shescitech/TIFR_Mask_Efficiency/design/README.md

# TIFR Mask Efficiency Measurement and Enhancement Setup

Here we present an easy to make Mask efficiency testing device using a Plantower 7003 sensor.
This sensor has been traditionally used for measuring Air Quality Index.

Different kinds of masks are available for protection against coronavirus, as shown in the image below:

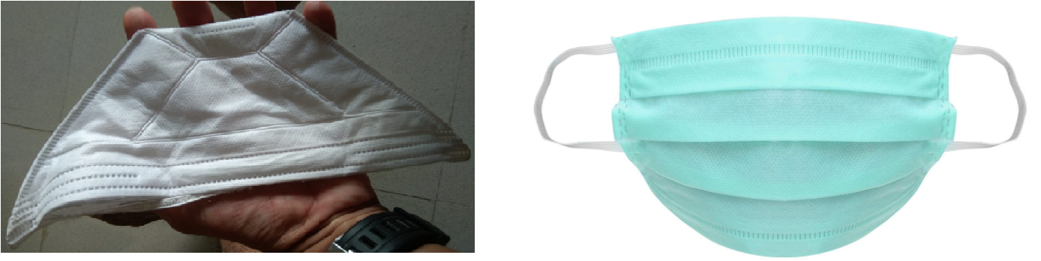
[picture p1: design/Masks.png]
alt Mask


Some people use a simple handkerchief or cloth to cover the face as well.

All of these have varying efficiencies of protection against the viruses. 

The project consists of all code design and documentation to design face mask efficiency tester

## Publication
Have a look at our pre-print to get more insight of our work
[Recharging improves efficiency of decontaminated N95 masks](https://arxiv.org/abs/2004.13641)

## Design of the Mask Tester
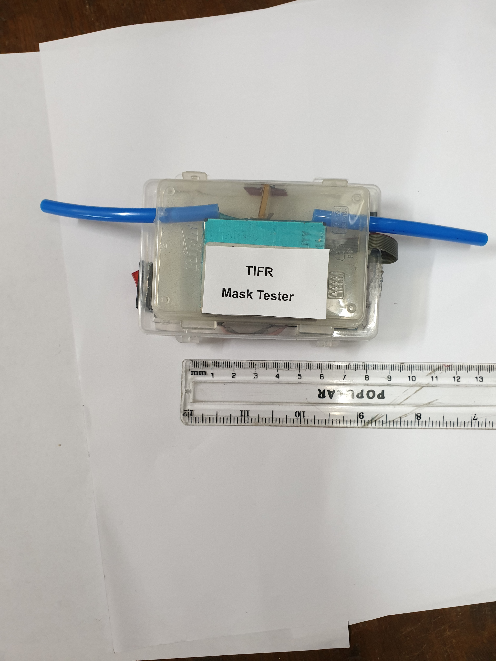
[picture p2: design/MaskTeseterClosed.jpg]
alt Mask


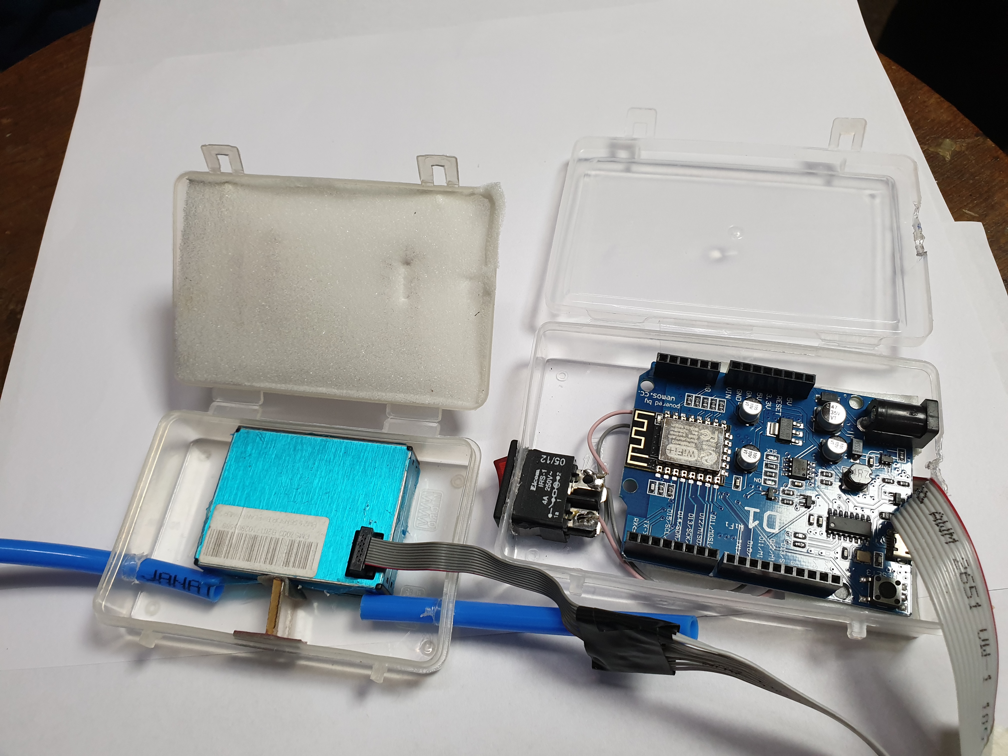
[picture p3: design/MaskTesterOpen.jpg]
alt Mask


## About us

We are a small group in TIFR working on the design of low cost mask testing equipment and efficient mask design. 

## Contact us

Want to discuss more with us:
Drop an email at shescitech@gmail.com
