shescitech/TIFR_Mask_Efficiency/python/README.md

# Data Recorder
1. You can use this file to get access to real time data from the particle counter via telnet server. For this you need to enable the telnet protocol in your computer if it is not enabled already. 
2. Add filters, analysis, and plot features as required. 
3. Data is finally exported to file "data.csv" by default.
