shescitech/TIFR_Mask_Efficiency/design/N95Mask.jpeg

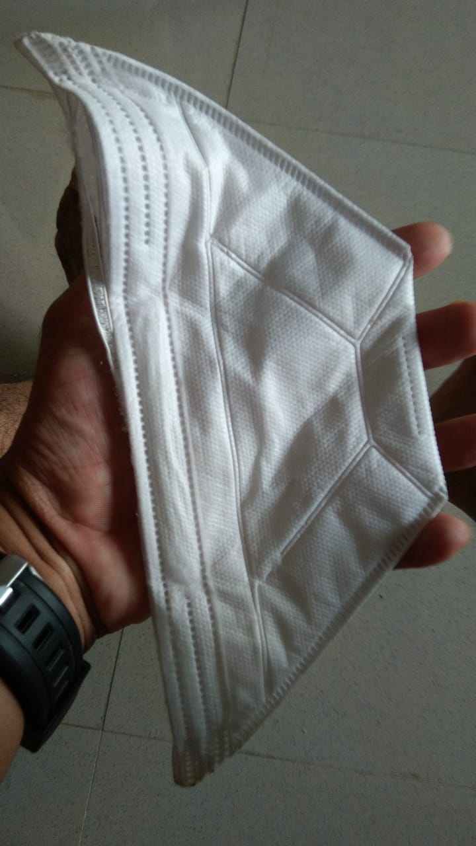
design/N95Mask.jpeg
