shescitech/TIFR_Mask_Efficiency/design/Schematic_ESP8266-PMS7003.png

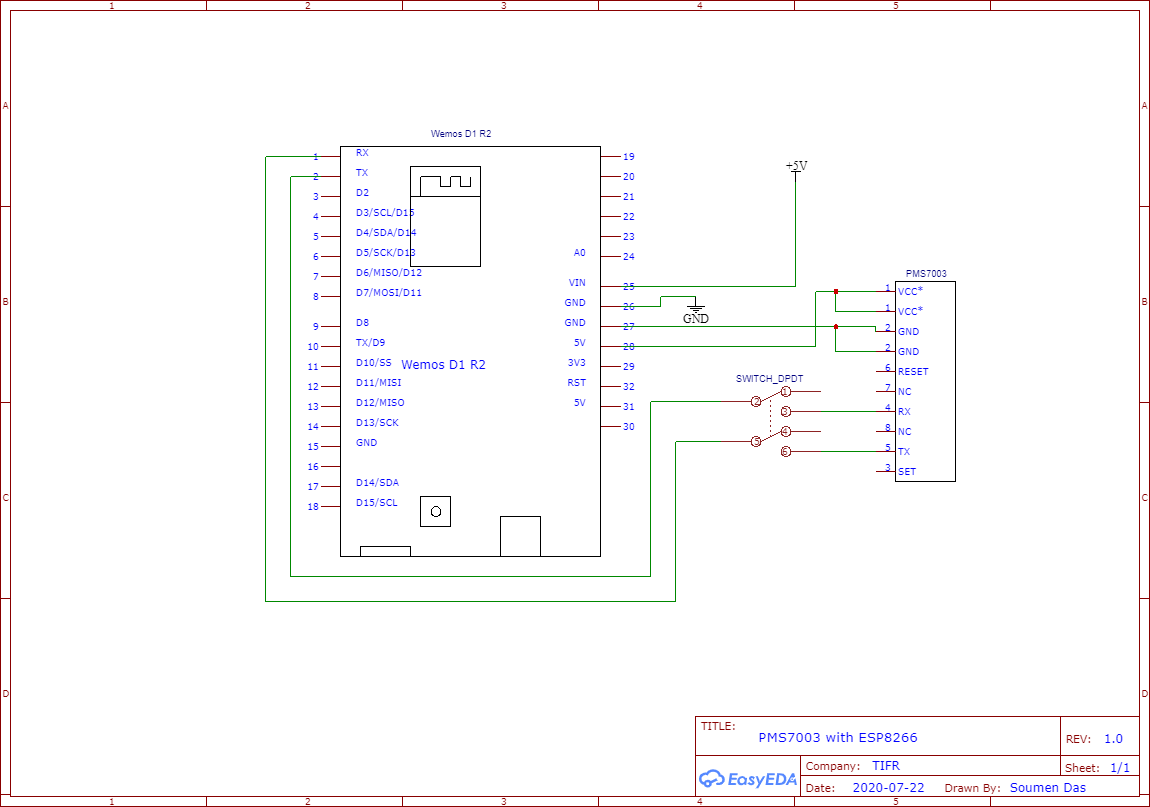
design/Schematic_ESP8266-PMS7003.png
