shescitech/TIFR_Mask_Efficiency/web/code/images/arnab.png

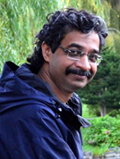
web/code/images/arnab.png
