shescitech/TIFR_Mask_Efficiency/web/code/images/emroj.png

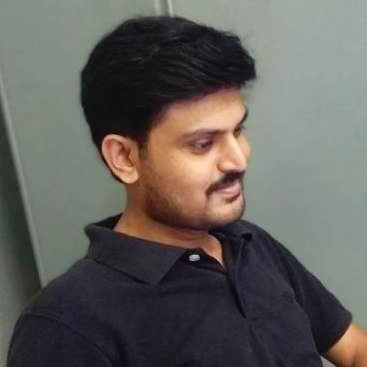
web/code/images/emroj.png
