shescitech/TIFR_Mask_Efficiency/web/code/images/harsh.jpg

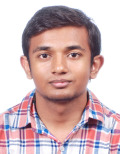
web/code/images/harsh.jpg
