shescitech/TIFR_Mask_Efficiency/web/code/images/satyanu.jpg

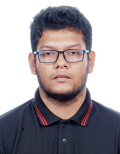
web/code/images/satyanu.jpg
