shescitech/TIFR_Mask_Efficiency/web/code/images/shankar.jpg

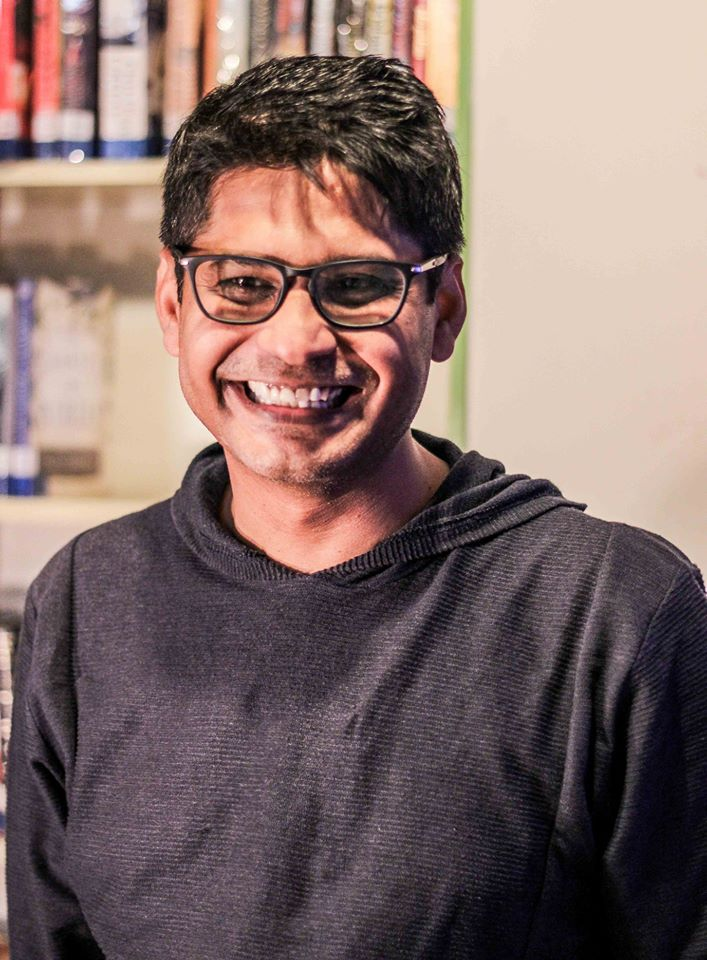
web/code/images/shankar.jpg
