shescitech/TIFR_Mask_Efficiency/web/code/images/soumen.jpg

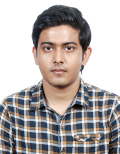
web/code/images/soumen.jpg
