shescitech/TIFR_Mask_Efficiency/design/Schematic_ESP8266-PMS7003.pdf

+5V

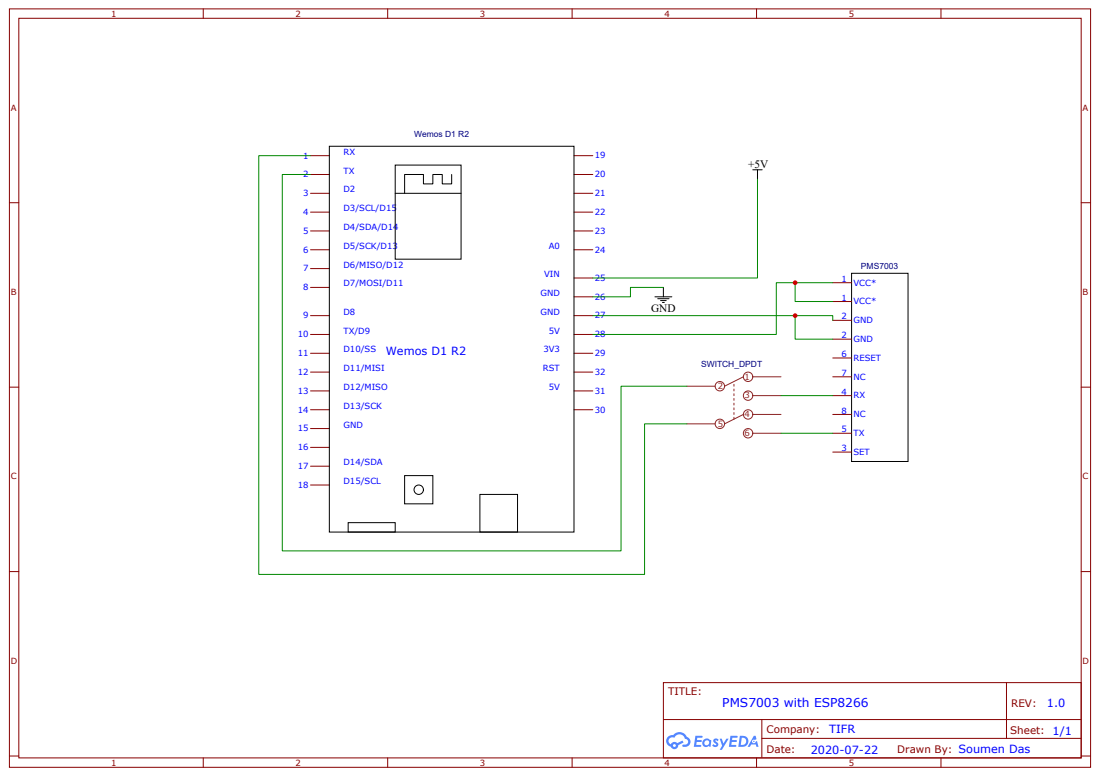
[picture p12: page 1]

Drawn By: Soumen Das
