shescitech/TIFR_Mask_Efficiency/(commit log)

2020-07-10 Add files via upload
    code to access data from device directly into python , you can add filter, real time analysis , and export data to file.
2020-07-22 Rename Arduino/README.md to Arduino codes/README.md
2020-07-22 Rename Arduino codes/README.md to Arduino/README.md
